matthiasbock/oled-control-board/cubemx/pinout.png

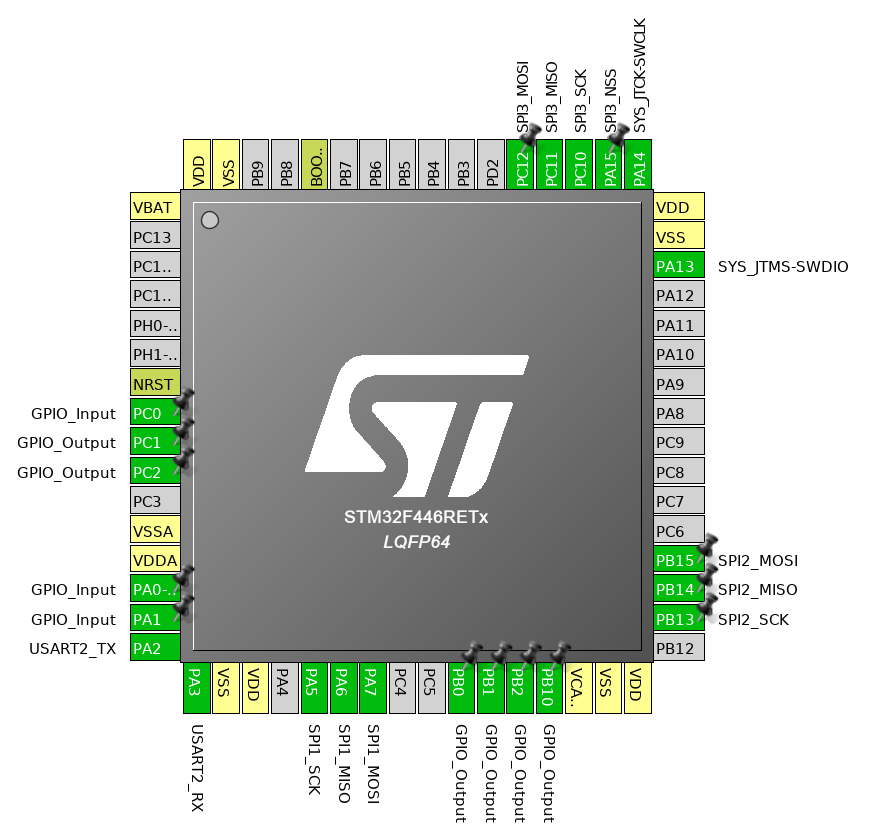
cubemx/pinout.png
