matthiasbock/oled-control-board/build/v1.0/schematic.pdf

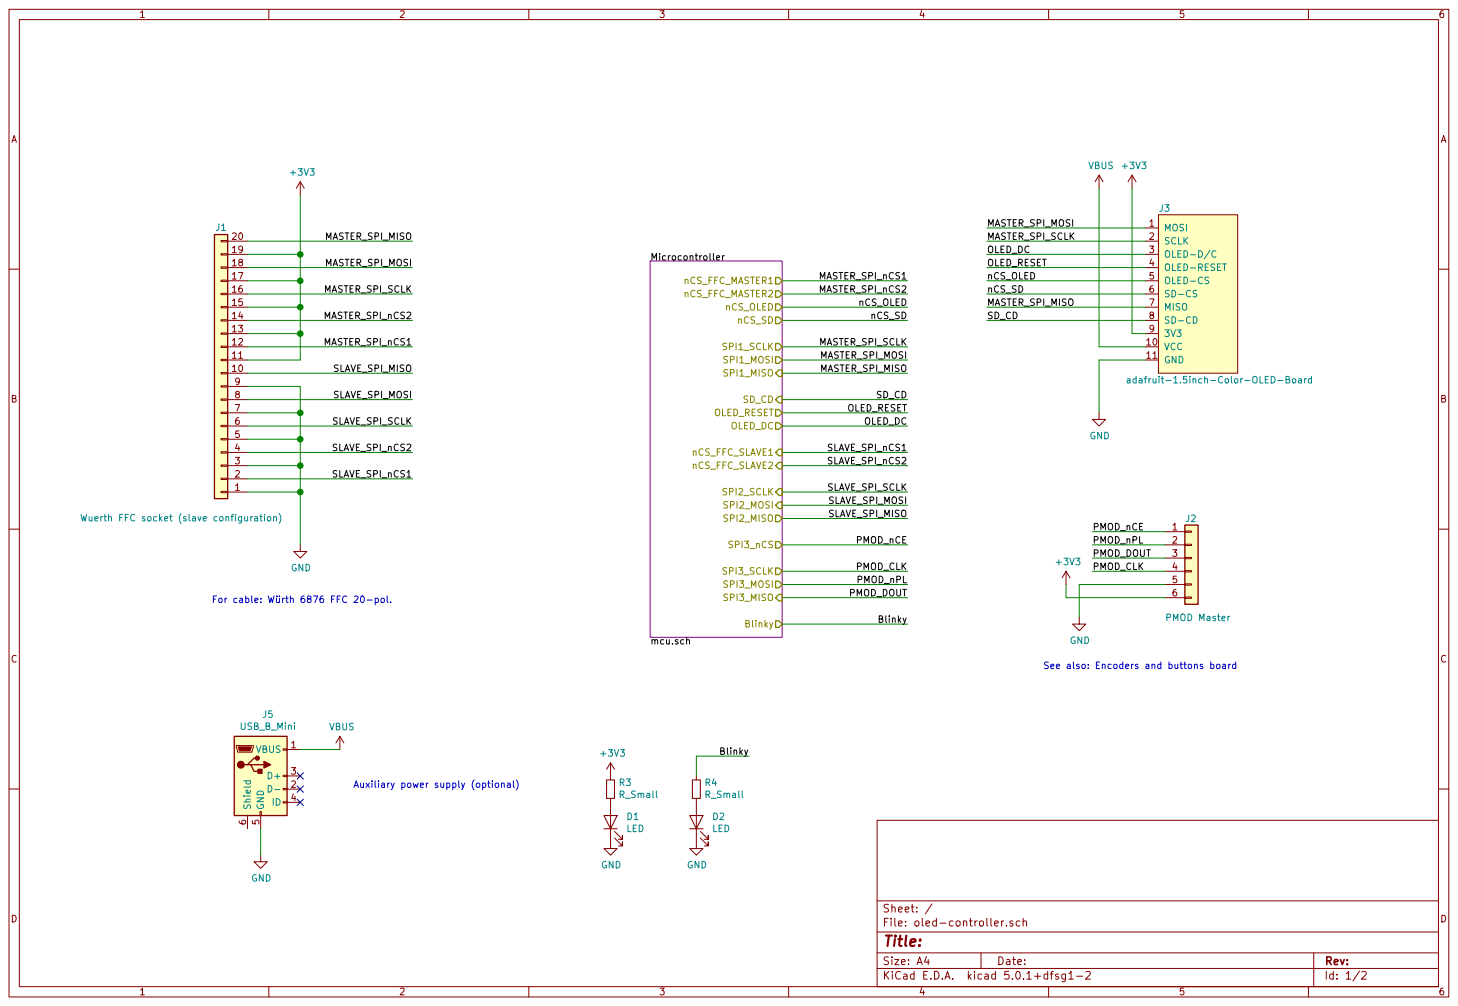
[picture p2: page 1]

adafruit-1.5inch-Color-OLED-Board

For cable: Würth 6876 FFC 20-pol. SLAVE_SPI_nCS1 SLAVE_SPI_nCS2 SLAVE_SPI_SCLK

J2 PMOD Master See also: Encoders and buttons board PMOD_nCE

Id: 1/2 Title: File: oled-controller.sch Sheet: /

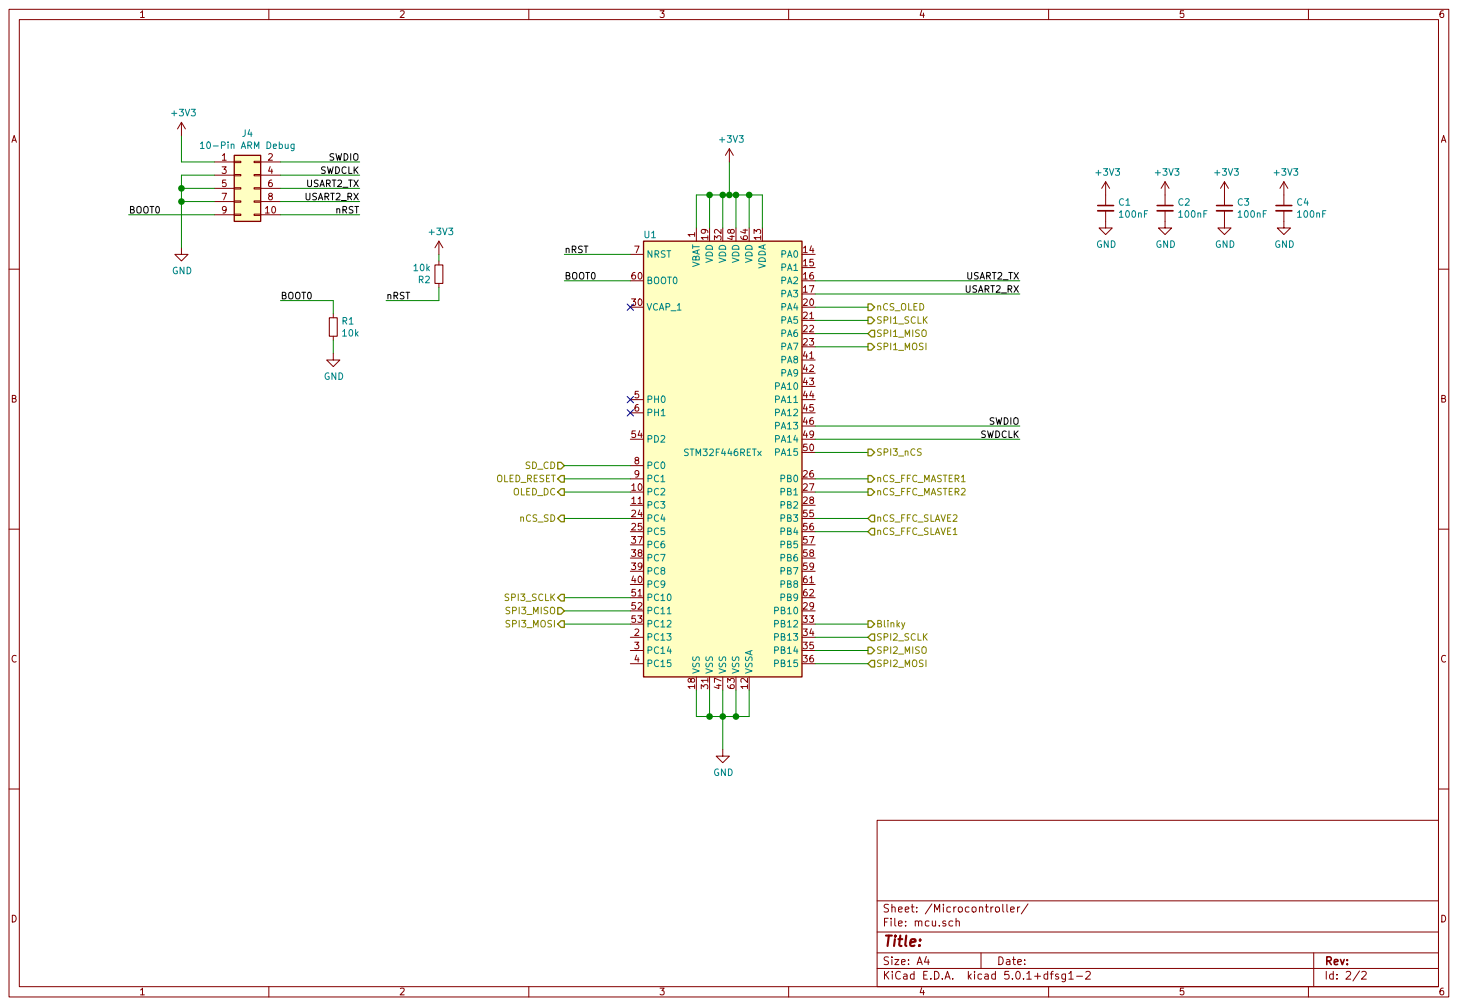
[picture p3: page 2]

10-Pin ARM Debug +3V3 GND

1 VCAP_1 30 VDD 19 VDD 32 VDD 48 VDD 64 VDDA 13 VSS 18 VSS 31 VSS 47 VSS 63 VSSA 12 U1 STM32F446RETx 1

Id: 2/2 Title: File: mcu.sch Sheet: /Microcontroller/
