matthiasbock/oled-control-board/oled-controller.kicad_pcb

## KiCad design oled-controller.kicad_pcb (2019-04-05)

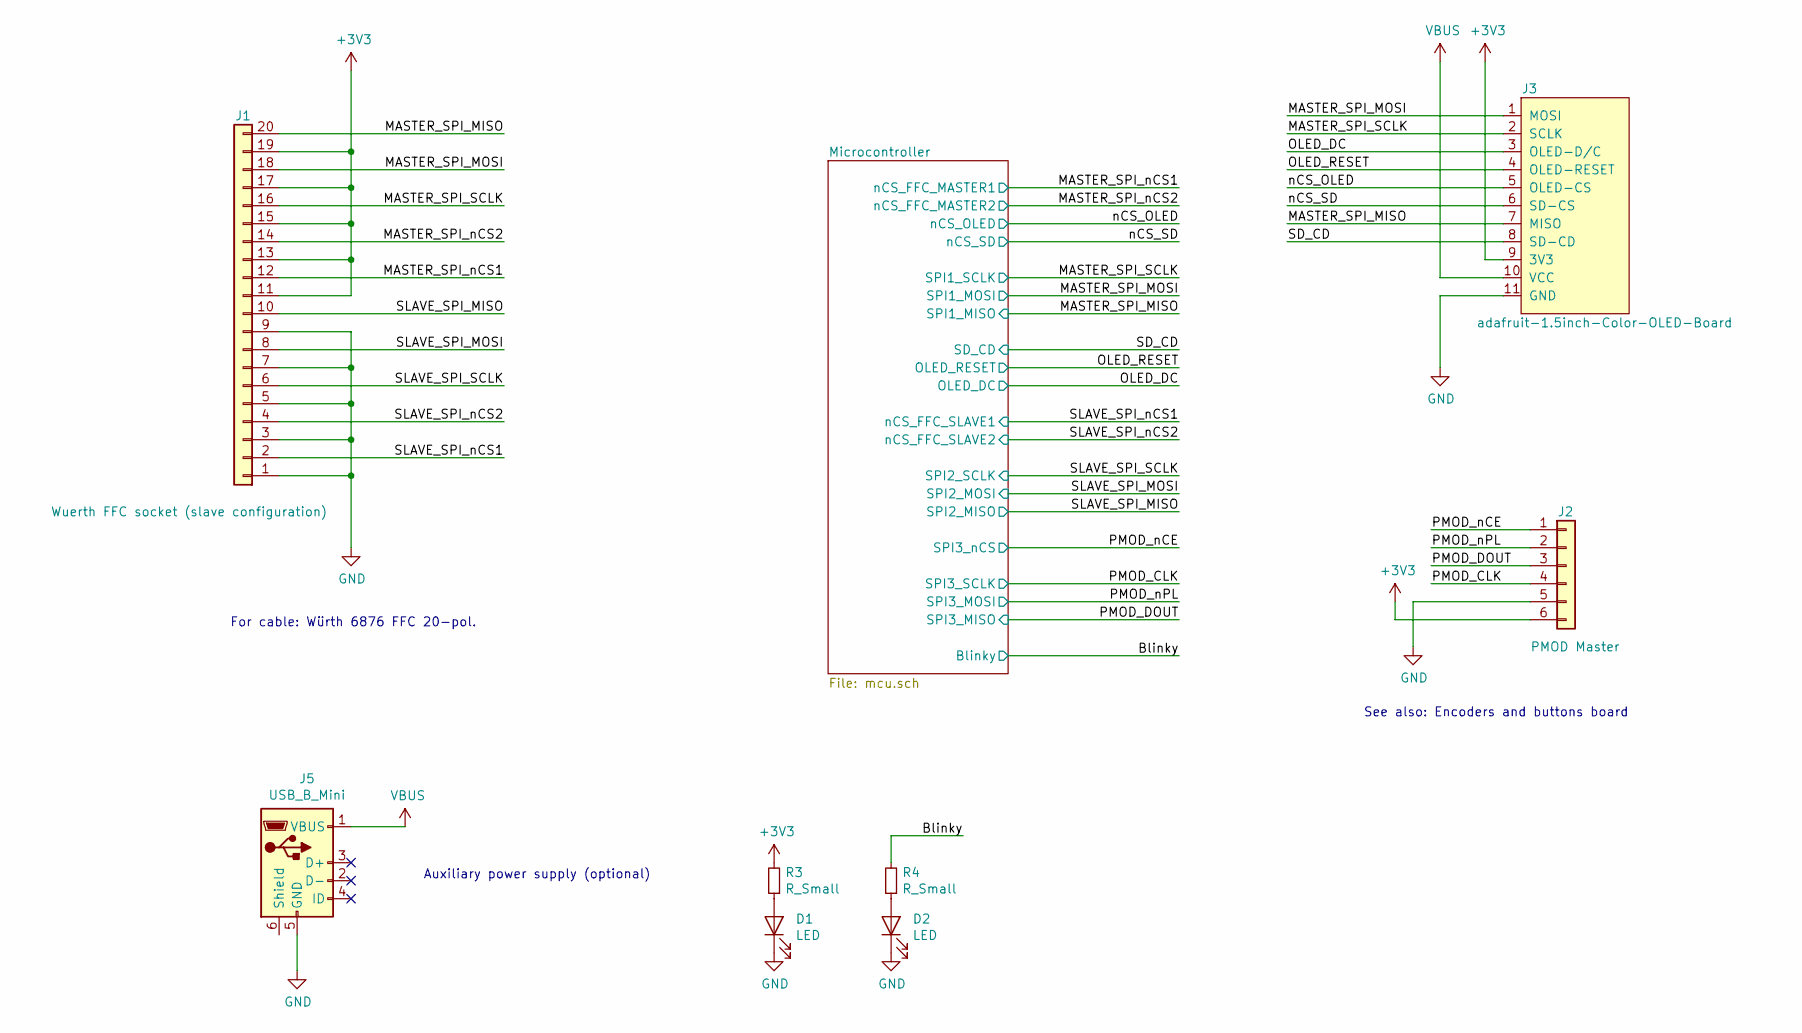
[picture p4: schematic oled-controller.sch]

Parts:
D1, D2: LED; D_0603_1608Metric_Pad1.05x0.95mm_HandSolder
J1: Wuerth FFC socket (slave configuration); Wuerth_687120149022_1x20-1MP_P0.5mm_Horizontal_Handsolder
J2: PMOD Master; PinHeader_1x06_P2.54mm_Vertical
J3: adafruit-1.5inch-Color-OLED-Board; Adafruit-1.5inch-Color-OLED-PCB
J5: USB_B_Mini; USB_Mini-B_Lumberg_2486_01_Horizontal
R3, R4: R_Small; R_0603_1608Metric_Pad1.05x0.95mm_HandSolder

Connections:
+3V3: J1.11, J1.13, J1.15, J1.17, J1.19, J2.6, J3.9 (3V3), R3.2; also elsewhere on the board
/Blinky: R4.2; also elsewhere on the board
/MASTER_SPI_MISO: J1.20, J3.7 (MISO); also elsewhere on the board
/MASTER_SPI_MOSI: J1.18, J3.1 (MOSI); also elsewhere on the board
/MASTER_SPI_SCLK: J1.16, J3.2 (SCLK); also elsewhere on the board
/MASTER_SPI_nCS1: J1.12; also elsewhere on the board
/MASTER_SPI_nCS2: J1.14; also elsewhere on the board
/OLED_DC: J3.3 (OLED-D/C); also elsewhere on the board
/OLED_RESET: J3.4 (OLED-RESET); also elsewhere on the board
/PMOD_CLK: J2.4; also elsewhere on the board
/PMOD_DOUT: J2.3; also elsewhere on the board
/PMOD_nCE: J2.1; also elsewhere on the board
/PMOD_nPL: J2.2; also elsewhere on the board
/SD_CD: J3.8 (SD-CD); also elsewhere on the board
/SLAVE_SPI_MISO: J1.10; also elsewhere on the board
/SLAVE_SPI_MOSI: J1.8; also elsewhere on the board
/SLAVE_SPI_SCLK: J1.6; also elsewhere on the board
/SLAVE_SPI_nCS1: J1.2; also elsewhere on the board
/SLAVE_SPI_nCS2: J1.4; also elsewhere on the board
/nCS_OLED: J3.5 (OLED-CS); also elsewhere on the board
/nCS_SD: J3.6 (SD-CS); also elsewhere on the board
GND: D1.1 (K), D2.1 (K), J1.1, J1.3, J1.5, J1.7, J1.9, J2.5, J3.11 (GND), J5.5 (GND); also elsewhere on the board
unnamed: D1.2 (A), R3.1
unnamed: D2.2 (A), R4.1
VBUS: J3.10 (VCC), J5.1 (VBUS)

Notes on the sheet:
For cable: Würth 6876 FFC 20-pol.
See also: Encoders and buttons board
Auxiliary power supply (optional)

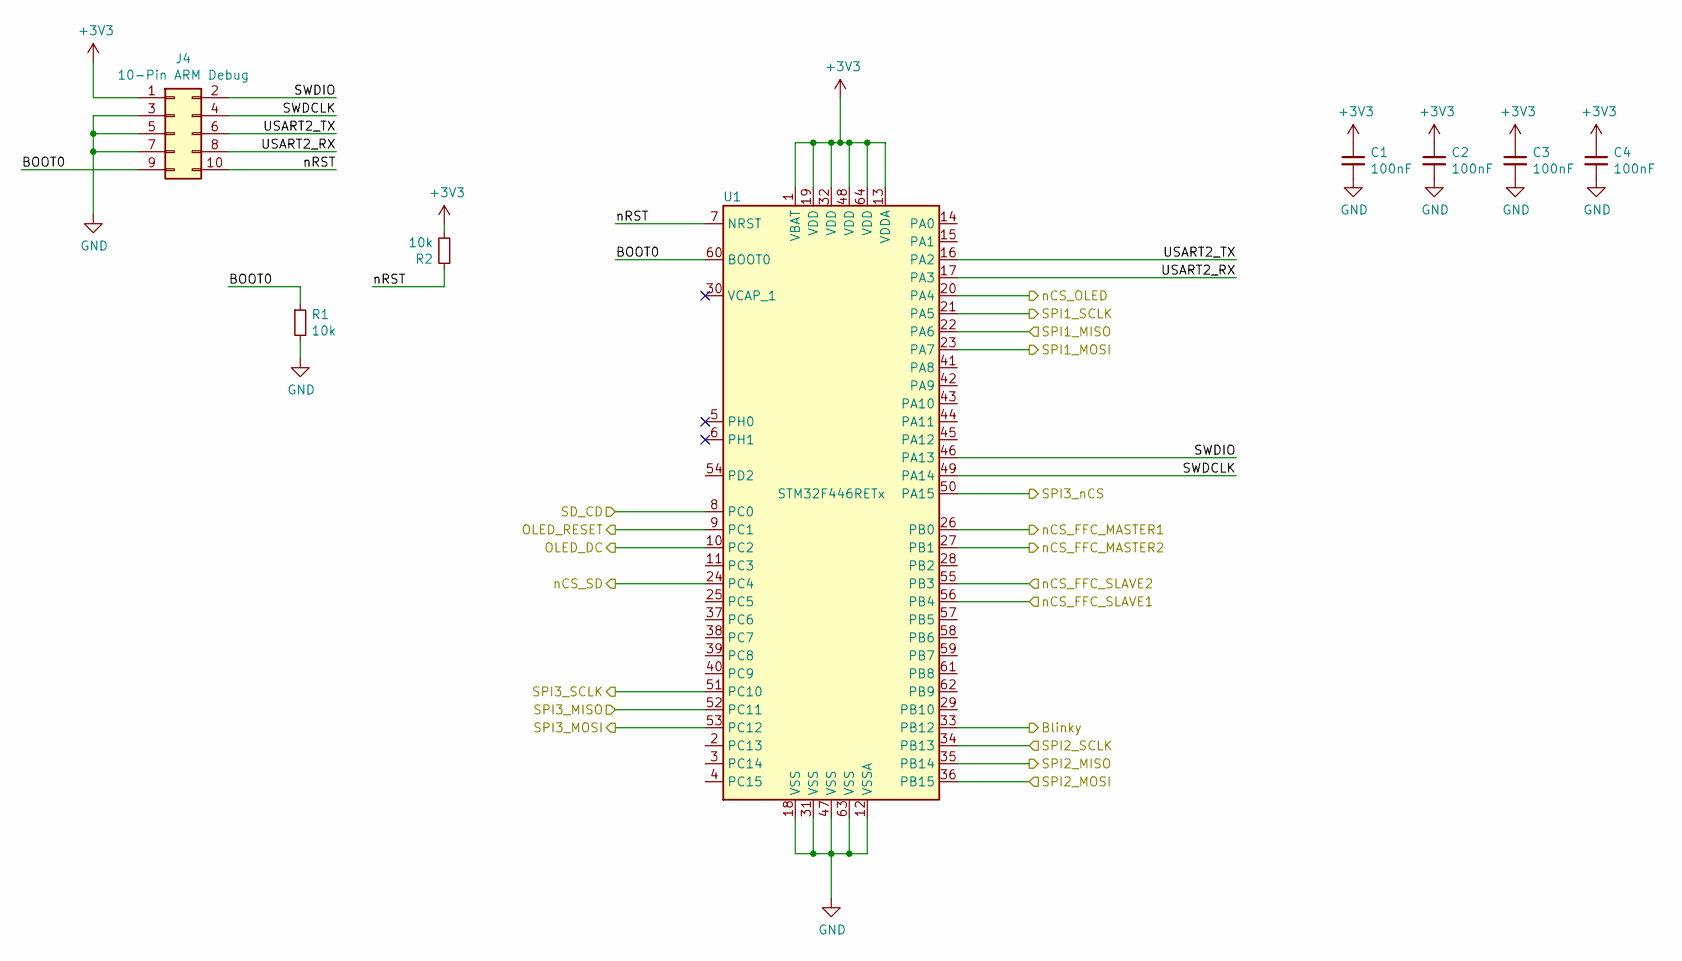
[picture p5: schematic mcu.sch]

Parts:
C1, C2, C3, C4: 100nF; C_0603_1608Metric_Pad1.05x0.95mm_HandSolder
J4: 10-Pin ARM Debug; PinHeader_2x05_P1.27mm_Vertical_SMD
R1, R2: 10k; R_0603_1608Metric_Pad1.05x0.95mm_HandSolder
U1: STM32F446RETx; LQFP-64_10x10mm_P0.5mm

Connections:
+3V3: C1.1, C2.1, C3.1, C4.1, J4.1, R2.2, U1.1 (VBAT), U1.13 (VDDA), U1.19 (VDD), U1.32 (VDD), U1.48 (VDD), U1.64 (VDD); also elsewhere on the board
/Blinky: U1.33 (PB12); also elsewhere on the board
/MASTER_SPI_MISO: U1.22 (PA6); also elsewhere on the board
/MASTER_SPI_MOSI: U1.23 (PA7); also elsewhere on the board
/MASTER_SPI_SCLK: U1.21 (PA5); also elsewhere on the board
/MASTER_SPI_nCS1: U1.26 (PB0); also elsewhere on the board
/MASTER_SPI_nCS2: U1.27 (PB1); also elsewhere on the board
/Microcontroller/BOOT0: J4.9, R1.1, U1.60 (BOOT0)
/Microcontroller/SWDCLK: J4.4, U1.49 (PA14)
/Microcontroller/SWDIO: J4.2, U1.46 (PA13)
/Microcontroller/USART2_RX: J4.8, U1.17 (PA3)
/Microcontroller/USART2_TX: J4.6, U1.16 (PA2)
/Microcontroller/nRST: J4.10, R2.1, U1.7 (NRST)
/OLED_DC: U1.10 (PC2); also elsewhere on the board
/OLED_RESET: U1.9 (PC1); also elsewhere on the board
/PMOD_CLK: U1.51 (PC10); also elsewhere on the board
/PMOD_DOUT: U1.52 (PC11); also elsewhere on the board
/PMOD_nCE: U1.50 (PA15); also elsewhere on the board
/PMOD_nPL: U1.53 (PC12); also elsewhere on the board
/SD_CD: U1.8 (PC0); also elsewhere on the board
/SLAVE_SPI_MISO: U1.35 (PB14); also elsewhere on the board
/SLAVE_SPI_MOSI: U1.36 (PB15); also elsewhere on the board
/SLAVE_SPI_SCLK: U1.34 (PB13); also elsewhere on the board
/SLAVE_SPI_nCS1: U1.56 (PB4); also elsewhere on the board
/SLAVE_SPI_nCS2: U1.55 (PB3); also elsewhere on the board
/nCS_OLED: U1.20 (PA4); also elsewhere on the board
/nCS_SD: U1.24 (PC4); also elsewhere on the board
GND: C1.2, C2.2, C3.2, C4.2, J4.3, J4.5, J4.7, R1.2, U1.12 (VSSA), U1.18 (VSS), U1.31 (VSS), U1.47 (VSS), U1.63 (VSS); also elsewhere on the board

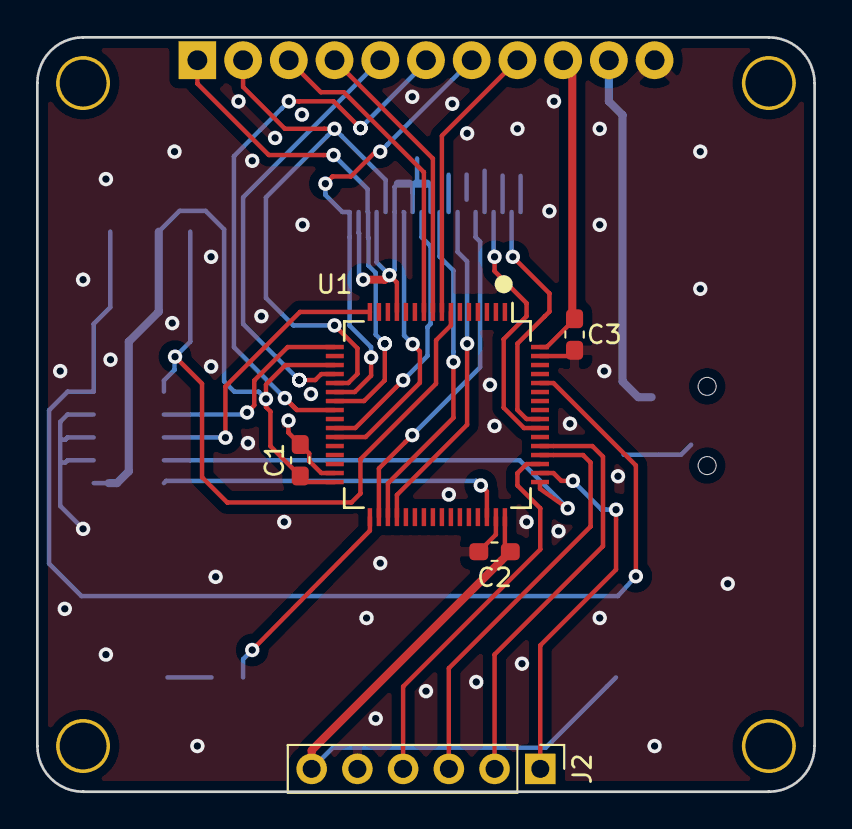
[picture p6: board oled-controller.kicad_pcb from above]

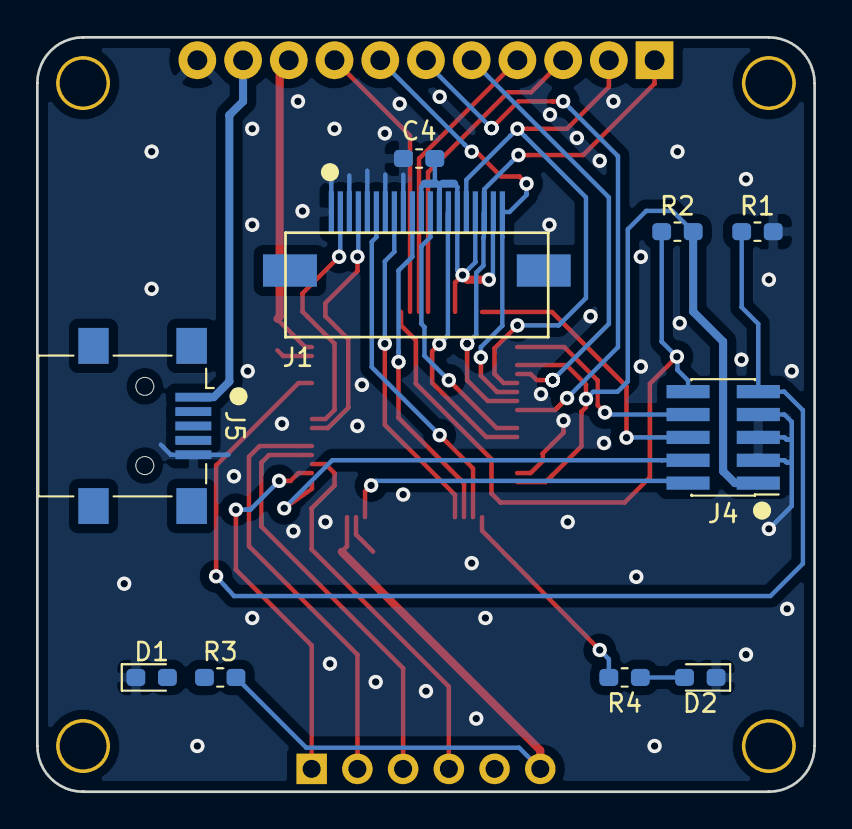
[picture p7: board oled-controller.kicad_pcb from below]

Board: 2 copper layers, 43.2 x 41.9 mm, 16 parts (10 on the bottom side), 31 nets.
