matthiasbock/oled-control-board/(threads)

Thread 1 (2019-04-19):

v1.0: Solder mask expansion too big

matthiasbock, 2019-04-19:
...at the MCU and at the FFC socket. This proves disadvantegous during soldering. The solder mask expansion should simply be zero.

Thread 2 (2019-04-19):

v1.0: Debugging problems

matthiasbock, 2019-04-19:
OpenOCD won't connect. Is it due to the missing quartz? Is a quartz required for SWD to work? I though, the internal RC would be sufficient...

3V3 are present at the MCU. Capacitors and resistors are equipped. Both SWD signals arrive on the MCU pins.

matthiasbock, 2019-04-19:
The [official datasheet](https://www.st.com/en/microcontrollers-microprocessors/stm32f446re.html) states:

~~~
On reset the 16 MHz internal RC oscillator is selected as the default CPU clock...
This clock can be monitored for failure. If a failure is detected, the system
automatically switches back to the internal RC oscillator...
~~~

matthiasbock, 2019-04-19:
I desoldered the microcontroller, soldered a new one and, considering issue #3, added a patch cable to supply pin 13 (VDDA) with 3.3V. After that OpenOCD could successfully establish a connection to the MCU. After removing the patch cable, it ceased to work again i.e. the debugger could not establish a connection to the MCU anymore. Re-attaching the patch cable and it worked again.

Conclusion: VDDA **must not** be left open, but must be connected to a supply voltage, otherwise the MCU won't be debuggable (probably won't run at all).

Thread 3 (2019-04-19):

v1.0 erratum: VDDA not connected to VDD

matthiasbock, 2019-04-19:
The 3,3V from the FFC are connected to pin 13 (VDDA), but not to VDD. This means, the MCU can not be powered from the FFC. It will always require auxiliary power, e.g. via the USB port.
