matthiasbock/oled-control-board/(commit log)

2019-03-01 Added my KiCad libraries as submodule
2019-03-01 Began empty KiCad 5 project
    [debugger.sch, mcu.sch, oled-controller.kicad_pcb, oled-controller.sch]
2019-03-29 Added FT2232D and OLED connector
    [debugger.sch, mcu.sch, oled-controller.sch]
2019-03-29 Moved USB and ESD protection to debugger schematic
    [debugger.sch, oled-controller.sch]
2019-03-31 Added hierarchical ports for SPI1-3 and others
    [mcu.sch, oled-controller.sch]
2019-03-31 Added PMOD connector and bypass capacitors
    [mcu.sch, oled-controller.sch]
2019-04-03 Added Adafruit OLED display board design files as submodule
2019-04-03 Completed schematic adjustments and layouting
    [mcu.sch, oled-controller.kicad_pcb, oled-controller.sch]
2019-04-04 Added two LEDs
    [mcu.sch, oled-controller.kicad_pcb, oled-controller.sch]
2019-04-05 PCB: Final adjustments
    [oled-controller.kicad_pcb]
2019-04-05 Exported fabrication files for revision 1
    [oled-controller-B.Cu.gbr, oled-controller-B.Mask.gbr, oled-controller-Edge.Cuts.gbr, oled-controller-F.Cu.gbr, oled-controller-F.Mask.gbr, oled-controller-NPTH.drl, oled-controller-PTH.drl]
2019-04-19 Added schematic PDF and plotted silkscreen layers
    [oled-controller-B.Cu.gbr, oled-controller-B.Mask.gbr, oled-controller-B.SilkS.gbr, oled-controller-Edge.Cuts.gbr, oled-controller-F.Cu.gbr, oled-controller-F.Mask.gbr, oled-controller-F.SilkS.gbr]
2019-04-19 Renamed rev1/ -> v1.0/
    [oled-controller-B.Cu.gbr, oled-controller-B.Mask.gbr, oled-controller-B.SilkS.gbr, oled-controller-Edge.Cuts.gbr, oled-controller-F.Cu.gbr, oled-controller-F.Mask.gbr, oled-controller-F.SilkS.gbr, oled-controller-NPTH.drl]
